joabzicg/Caiman/README.md

# Caiman

## Electronics

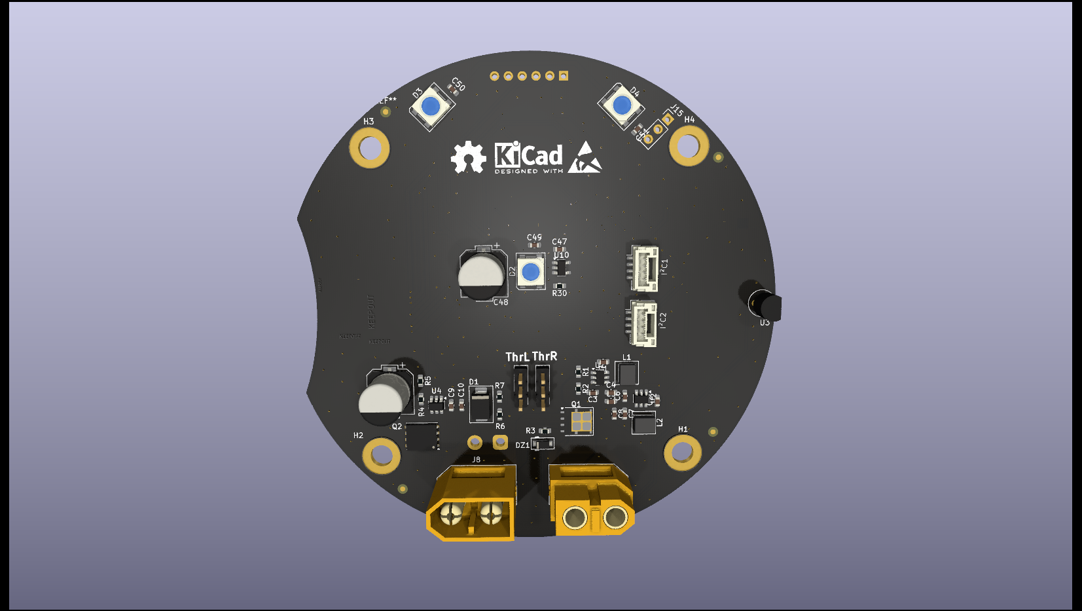
[picture p1: docs/caiman_pcb_front.png]
PCB Front view

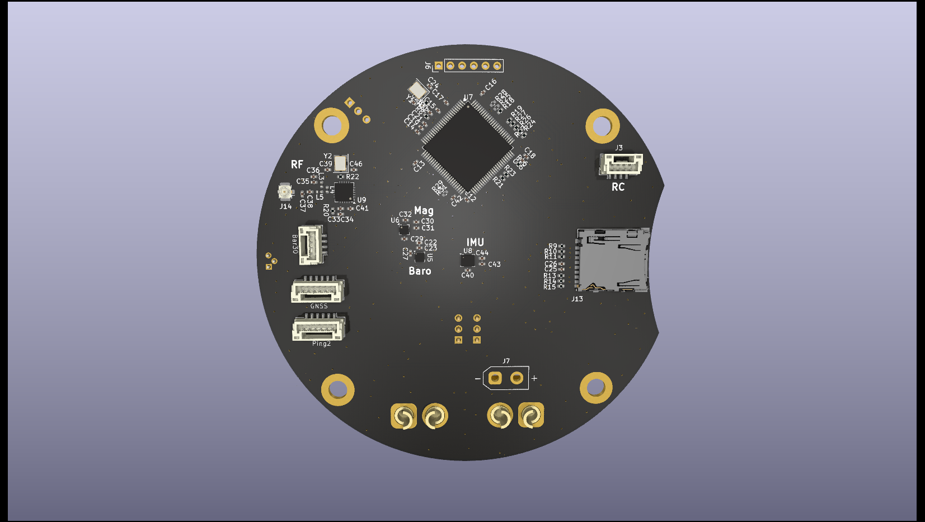
[picture p2: docs/caiman_pcb_rear.png]
PCB Rear view
