joabzicg/Caiman/electronics/production/bom_clean.csv

Designator | Footprint | Quantity | Value | LCSC Part #
C1, C2 | 0603 | 2 | 100nF
C10, C9 | 0805 | 2 | 0.1uF, 50V
C11 | CP_Elec_8x10 | 1 | 47uF, 50v
C12, C13, C14, C15, C16, C17, C18, C19, C20, C23, C26, C27, C31, C32, C40, C43 | 0402 | 16 | 100nf
C21 | 0402 | 1 | 1uF
C22, C25 | 0402 | 2 | 4.7uf
C24, C28 | 0402 | 2 | 18pF
C29 | 0402 | 1 | 220nf
C3 | 0805 | 1 | 10uF, 50v
C30, C44 | 0402 | 2 | 10uf
C33 | 0402 | 1 | 10nf
C34 | 0402 | 1 | 1nf
C35 | 0402 | 1 | 2.2nF
C36 | 0402 | 1 | 4.7pF
C37 | 0402 | 1 | 1pF
C38 | 0402 | 1 | 1.5pF
C39, C46 | 0402 | 2 | 22pF
C4, C5, C7, C8 | 0603 | 4 | 22uF, 16V
C41 | 0402 | 1 | 33nf
C42, C45 | 0402 | 2 | 2.2uF
C47, C49, C50, C51 | 0603 | 4 | 0.1uF
C48 | CP_Elec_8x10 | 1 | 470uF
C6 | 0805 | 1 | 10uF, 16v
D1 | D_SMB_TVS | 1 | SMBJ33CA
D2, D3, D4 | LED_SK6812_PLCC4_5.0x5.0mm_P3.2mm | 3 | SK6812
DZ1 | D_SOD-123F_Zener | 1 | MMSZ5245
J1, J4 | PinHeader_1x03_P2.54mm_Vertical | 2 | Conn_01x03_Pin
J10, J11, J12, J3 | JST_GH_BM04B-GHS-TBT_1x04-1MP_P1.25mm_Vertical | 4 | Conn_01x04_Pin
J13 | microSD_HC_Hirose_DM3AT-SF-PEJM5 | 1 | Micro_SD_Card
J14 | U.FL_Hirose_U.FL-R-SMT-1_Vertical | 1 | 50 ohm
J2, J5 | JST_GH_BM06B-GHS-TBT_1x06-1MP_P1.25mm_Vertical | 2 | Conn_01x04_Pin
J7 | AMASS_XT30UPB-M_1x02_P5.0mm_Vertical | 1 | Conn_01x02_Pin
J8 | AMASS_XT60-M_1x02_P7.20mm_Vertical | 1 | Conn_01x02_Pin
J9 | AMASS_XT60-F_1x02_P7.20mm_Vertical | 1 | Conn_01x02_Pin
L1 | L_Wuerth_MAPI-4020 | 1 | 4.7uH
L2 | L_Wuerth_MAPI-4020 | 1 | 3.9uH
L3 | 0402 | 1 | 2.7nH
L4 | 0402 | 1 | 8.2nH
L5 | 0402 | 1 | 3.9nH
Q1 | PowerPAK_SO-8L_Single | 1 | Q_PMOS-E_Generic_SSSGD
Q2 | TDSON-8-1 | 1 | AON6262E
R1, R4, R6 | 0603 | 3 | 100k
R10, R11, R12, R14, R15, R16, R8, R9 | 0402 | 8 | 10k
R13 | 0402 | 1 | 47k
R17, R18, R19 | 0402 | 3 | 22 ohm
R2 | 0603 | 1 | 15k
R20, R22, R24, R25, R27, R28 | 0402 | 6 | 22ohm
R21 | 0402 | 1 | 22k
R23 | 0402 | 1 | 1M
R3, R7 | 0603 | 2 | 10k
R31 | 0603 | 1 | 330
R5 | 0603 | 1 | 27k
U1 | TSOT-23-6 | 1 | AP63205WU
U10 | SOT-23-5 | 1 | SN74LV1T34DBV
U2 | TSOT-23-6 | 1 | AP63203WU
U3 | TO-92 | 1 | US1881
U4 | SOT-23-6 | 1 | LM74700
U5 | ST_HLGA-10_2x2mm_P0.5mm_LayoutBorder3x2y | 1 | LPS22HBTR
U6 | LGA-12_2x2mm_P0.5mm | 1 | LIS2MDLTR
U7 | LQFP-100_14x14mm_P0.5mm | 1 | STM32F765VITx
U8 | LGA-14_3x2.5mm_P0.5mm_LayoutBorder3x4y | 1 | LSM6DSO
U9 | QFN-20-1EP_4x4mm_P0.5mm_EP2.5x2.5mm | 1 | nRF24L01P
Y1 | Crystal_SMD_3225-4Pin_3.2x2.5mm | 1 | 8MHz
Y2 | Crystal_SMD_3225-4Pin_3.2x2.5mm | 1 | 16MHz
