joabzicg/Caiman/electronics/caiman.kicad_pcb

## KiCad design electronics/caiman.kicad_pcb (2026-06-23)

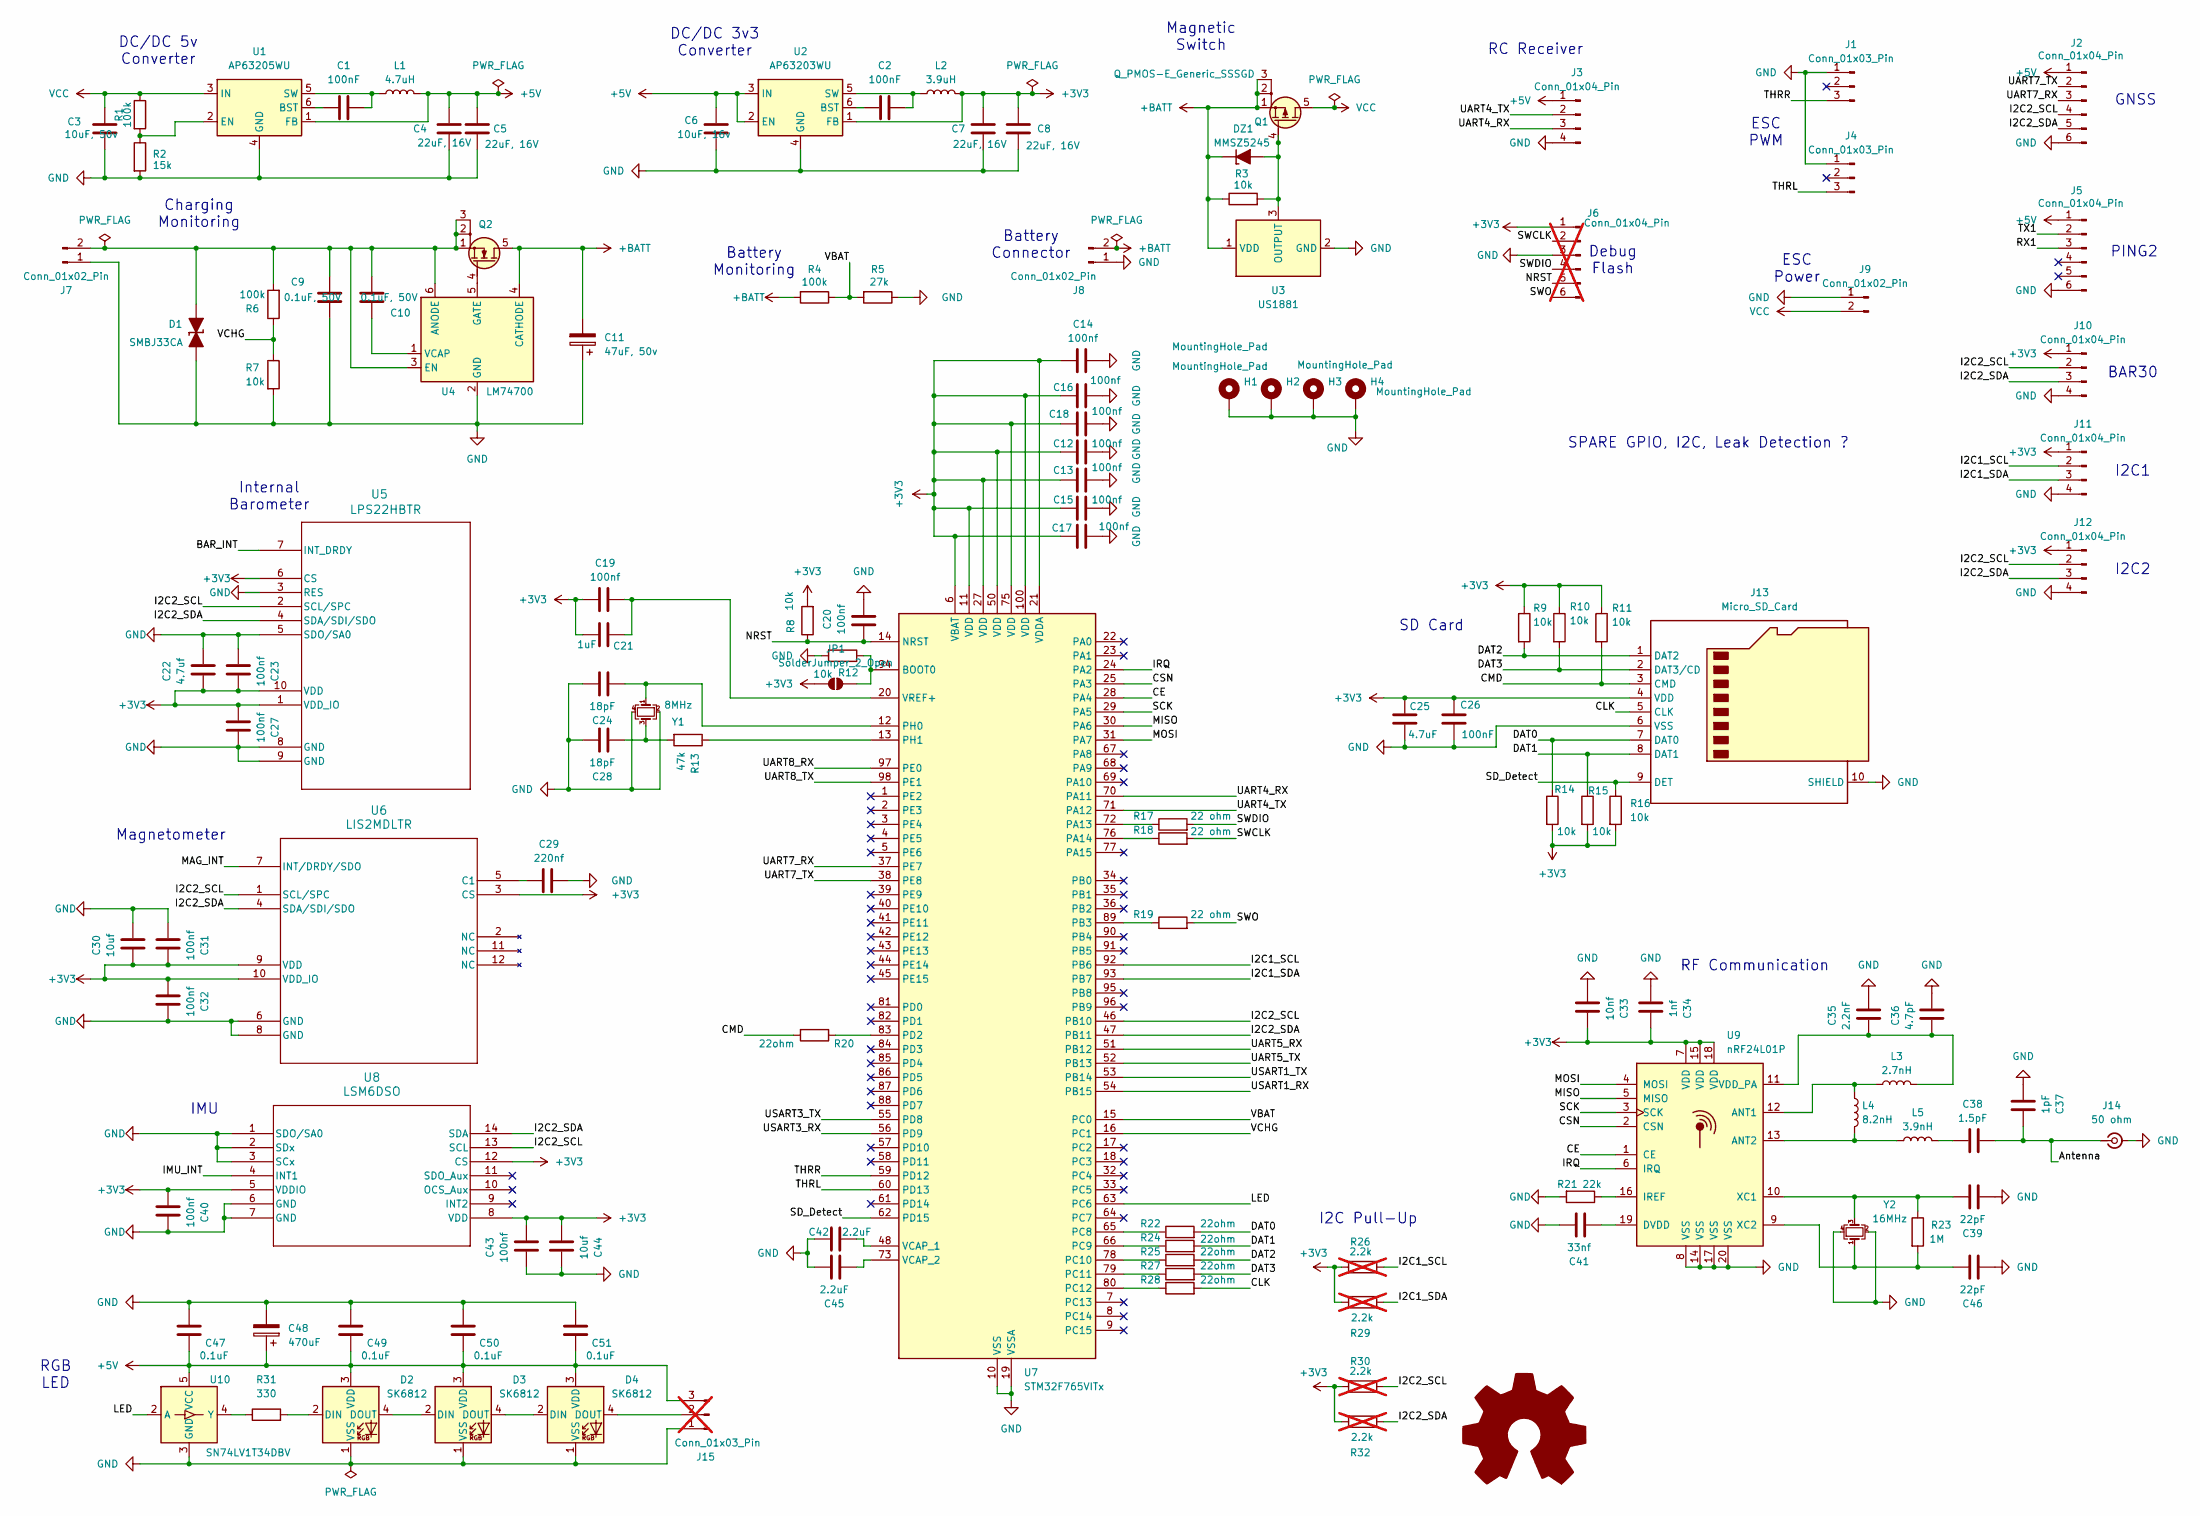
[picture p3: schematic caiman.kicad_sch]

Parts:
C1, C2: 100nF; C_0603_1608Metric
C3: 10uF, 50v; C_0805_2012Metric
C4, C5, C7, C8: 22uF, 16V; C_0603_1608Metric
C6: 10uF, 16v; C_0805_2012Metric
C9, C10: 0.1uF, 50V; C_0805_2012Metric
C11: 47uF, 50v; CP_Elec_8x10; Mouser 581-AEA0810470M063R
C12, C13, C14, C15, C16, C17, C18, C19, C20, C23, C27, C31, C32, C40, C43: 100nf; C_0402_1005Metric
C21: 1uF; C_0402_1005Metric
C22: 4.7uf; C_0402_1005Metric
C24, C28: 18pF; C_0402_1005Metric
C25: 4.7uF; C_0402_1005Metric
C26: 100nF; C_0402_1005Metric
C29: 220nf; C_0402_1005Metric
C30, C44: 10uf; C_0402_1005Metric
C33: 10nf; C_0402_1005Metric
C34: 1nf; C_0402_1005Metric
C35: 2.2nF; C_0402_1005Metric
C36: 4.7pF; C_0402_1005Metric
C37: 1pF; C_0402_1005Metric
C38: 1.5pF; C_0402_1005Metric
C39, C46: 22pF; C_0402_1005Metric
C41: 33nf; C_0402_1005Metric
C42, C45: 2.2uF; C_0402_1005Metric
C47, C49, C50, C51: 0.1uF; C_0603_1608Metric
C48: 470uF; CP_Elec_8x10; Mouser 581-AEA0810471M016R
D1: SMBJ33CA; D_SMB_TVS; Mouser 652-SMBJ33CA
D2, D3, D4: SK6812; LED_SK6812_PLCC4_5.0x5.0mm_P3.2mm; Mouser 485-4691
DZ1: MMSZ5245; D_SOD-123F_Zener
H1, H2, H3, H4: MountingHole_Pad; MountingHole_4.3mm_M4_ISO7380_Pad_TopBottom
J1, J4: Conn_01x03_Pin; PinHeader_1x03_P2.54mm_Vertical
J2, J5: Conn_01x04_Pin; JST_GH_BM06B-GHS-TBT_1x06-1MP_P1.25mm_Vertical; Mouser 306-BM06BGHSTBTLFSNN
J3, J10, J11, J12: Conn_01x04_Pin; JST_GH_BM04B-GHS-TBT_1x04-1MP_P1.25mm_Vertical; Mouser 306-BM04BGHSTBTLFSNN
J6: Conn_01x04_Pin; PinHeader_1x06_P2.54mm_Vertical; not fitted
J7: Conn_01x02_Pin; AMASS_XT30UPB-M_1x02_P5.0mm_Vertical; Mouser 426-FIT0587
J8: Conn_01x02_Pin; AMASS_XT60-M_1x02_P7.20mm_Vertical; Mouser 426-FIT0587
J9: Conn_01x02_Pin; AMASS_XT60-F_1x02_P7.20mm_Vertical; Mouser 426-FIT0587
J13: Micro_SD_Card; microSD_HC_Hirose_DM3AT-SF-PEJM5; Mouser 798-DM3ATSFPEJM511
J14: 50 ohm; U.FL_Hirose_U.FL-R-SMT-1_Vertical
J15: Conn_01x03_Pin; PinHeader_1x03_P2.54mm_Vertical; not fitted
JP1: SolderJumper_2_Open; SolderJumper-2_P1.3mm_Open_TrianglePad1.0x1.5mm
L1: 4.7uH; L_Wuerth_MAPI-4020; Mouser 652-SRP4020FA-3R3M
L2: 3.9uH; L_Wuerth_MAPI-4020; Mouser 652-SRP4020FA-2R2M
L3: 2.7nH; L_0402_1005Metric
L4: 8.2nH; L_0402_1005Metric
L5: 3.9nH; L_0402_1005Metric
Q1: Q_PMOS-E_Generic_SSSGD; PowerPAK_SO-8L_Single; Mouser 78-SQJ457EP-T1_GE3
Q2: AON6262E; TDSON-8-1; Digikey 800-3747-2-ND
R1, R4, R6: 100k; R_0603_1608Metric
R2: 15k; R_0603_1608Metric
R3, R7: 10k; R_0603_1608Metric
R5: 27k; R_0603_1608Metric
R8, R9, R10, R11, R12, R14, R15, R16: 10k; R_0402_1005Metric
R13: 47k; R_0402_1005Metric
R17, R18, R19: 22 ohm; R_0402_1005Metric
R20, R22, R24, R25, R27, R28: 22ohm; R_0402_1005Metric
R21: 22k; R_0402_1005Metric
R23: 1M; R_0402_1005Metric
R26, R29, R30, R32: 2.2k; R_0402_1005Metric; not fitted
R31: 330; R_0603_1608Metric
U1: AP63205WU; TSOT-23-6; Mouser 621-AP63205WU-7
U2: AP63203WU; TSOT-23-6; Mouser 621-AP63203WU-7
U3: US1881; TO-92; Mouser 482-1881LUAAAA000BU
U4: LM74700; SOT-23-6; Mouser 595-LM74700QDBVRQ1
U5: LPS22HBTR; ST_HLGA-10_2x2mm_P0.5mm_LayoutBorder3x2y
U6: LIS2MDLTR; LGA-12_2x2mm_P0.5mm
U7: STM32F765VITx; LQFP-100_14x14mm_P0.5mm
U8: LSM6DSO; LGA-14_3x2.5mm_P0.5mm_LayoutBorder3x4y
U9: nRF24L01P; QFN-20-1EP_4x4mm_P0.5mm_EP2.5x2.5mm
U10: SN74LV1T34DBV; SOT-23-5; Mouser 595-SN74LV1T34DBVRG4
Y1: 8MHz; Crystal_SMD_3225-4Pin_3.2x2.5mm
Y2: 16MHz; Crystal_SMD_3225-4Pin_3.2x2.5mm

Connections:
+3V3: C7.2, C8.2, C12.2, C13.2, C14.2, C15.2, C16.2, C17.2, C18.2, C19.2, C21.2, C22.1, C23.1, C25.1, C26.1, C27.2, C30.1, C31.1, C32.2, C33.1, C34.1, C40.2, C43.2, C44.2, J6.1, J10.1, J11.1, J12.1, J13.4 (VDD), JP1.1 (A), L2.2, R8.2, R9.1, R10.1, R11.1, R14.2, R15.2, R16.2, R26.1, R29.1, R30.1, R32.1, U2.1 (FB), U5.1 (VDD_IO), U5.6 (CS), U5.10 (VDD), U6.3 (CS), U6.9 (VDD), U6.10 (VDD_IO), U7.6 (VBAT), U7.11 (VDD), U7.21 (VDDA), U7.27 (VDD), U7.50 (VDD), U7.75 (VDD), U7.100 (VDD), U8.5 (VDDIO), U8.8 (VDD), U8.12 (CS), U9.7 (VDD), U9.15 (VDD), U9.18 (VDD)
+5V: C4.2, C5.2, C6.2, C47.2, C48.1, C49.2, C50.2, C51.2, D2.3 (VDD), D3.3 (VDD), D4.3 (VDD), J2.1, J3.1, J5.1, J15.3, L1.2, U1.1 (FB), U2.2 (EN), U2.3 (IN), U10.5 (VCC)
+BATT: C11.2, DZ1.1 (K), J8.2, Q1.1 (S), Q1.2 (S), Q1.3 (S), Q2.5 (D), R3.1, R4.2, U3.1 (VDD), U4.4 (CATHODE)
/Antenna: C37.2, C38.2, J14.1 (In)
/BAR_INT: U5.7 (INT_DRDY)
/CE: U7.28 (PA4), U9.1 (CE)
/CLK: J13.5 (CLK), R28.2
/CMD: J13.3 (CMD), R11.2, R20.2
/CSN: U7.25 (PA3), U9.2 (CSN)
/DAT0: J13.7 (DAT0), R14.1, R22.2
/DAT1: J13.8 (DAT1), R15.1, R24.2
/DAT2: J13.1 (DAT2), R9.2, R25.2
/DAT3: J13.2 (DAT3/CD), R10.2, R27.2
/I2C1_SCL: J11.2, R26.2, U7.92 (PB6)
/I2C1_SDA: J11.3, R29.2, U7.93 (PB7)
/I2C2_SCL: J2.4, J10.2, J12.2, R30.2, U5.2 (SCL/SPC), U6.1 (SCL/SPC), U7.46 (PB10), U8.13 (SCL)
/I2C2_SDA: J2.5, J10.3, J12.3, R32.2, U5.4 (SDA/SDI/SDO), U6.4 (SDA/SDI/SDO), U7.47 (PB11), U8.14 (SDA)
/IMU_INT: U8.4 (INT1)
/IRQ: U7.24 (PA2), U9.6 (IRQ)
/LED: U7.63 (PC6), U10.2 (A)
/MAG_INT: U6.7 (INT/DRDY/SDO)
/MISO: U7.30 (PA6), U9.5 (MISO)
/MOSI: U7.31 (PA7), U9.4 (MOSI)
/NRST: C20.2, J6.5, R8.1, U7.14 (NRST)
/RX1: J5.3
/SCK: U7.29 (PA5), U9.3 (SCK)
/SD_Detect: J13.9 (DET), R16.1, U7.62 (PD15)
/SWCLK: J6.2, R18.2
/SWDIO: J6.4, R17.2
/SWO: J6.6, R19.2
/THRL: J4.3, U7.60 (PD13)
/THRR: J1.3, U7.59 (PD12)
/TX1: J5.2
/UART4_RX: J3.3, U7.70 (PA11)
/UART4_TX: J3.2, U7.71 (PA12)
/UART5_RX: U7.51 (PB12)
/UART5_TX: U7.52 (PB13)
/UART7_RX: J2.3, U7.37 (PE7)
/UART7_TX: J2.2, U7.38 (PE8)
/UART8_RX: U7.97 (PE0)
/UART8_TX: U7.98 (PE1)
/USART1_RX: U7.54 (PB15)
/USART1_TX: U7.53 (PB14)
/USART3_RX: U7.56 (PD9)
/USART3_TX: U7.55 (PD8)
/VBAT: R4.1, R5.2, U7.15 (PC0)
/VCHG: R6.1, R7.1, U7.16 (PC1)
GND: C3.1, C4.1, C5.1, C6.1, C7.1, C8.1, C9.2, C11.1, C12.1, C13.1, C14.1, C15.1, C16.1, C17.1, C18.1, C20.1, C22.2, C23.2, C24.1, C25.2, C26.2, C27.1, C28.1, C29.1, C30.2, C31.2, C32.1, C33.2, C34.2, C35.2, C36.2, C37.1, C39.2, C40.1, C41.1, C42.2, C43.1, C44.1, C45.1, C46.2, C47.1, C48.2, C49.1, C50.1, C51.1, D1.1 (K), D2.1 (VSS), D3.1 (VSS), D4.1 (VSS), H1.1 (1_1), H2.1 (1_1), H3.1 (1_1), H4.1 (1_1), J1.1, J2.6, J3.4, J4.1, J5.6, J6.3, J7.1, J8.1, J9.1, J10.4, J11.4, J12.4, J13.6 (VSS), J13.10 (SHIELD), J14.2 (Ext), J15.1, R2.2, R5.1, R7.2, R12.2, R21.2, U1.4 (GND), U2.4 (GND), U3.2 (GND), U4.2 (GND), U5.3 (RES), U5.5 (SDO/SA0), U5.8 (GND), U5.9 (GND), U6.6 (GND), U6.8 (GND), U7.10 (VSS), U7.19 (VSSA), U7.26 (VSS), U7.49 (VSS), U7.74 (VSS), U7.99 (VSS), U8.1 (SDO/SA0), U8.2 (SDx), U8.3 (SCx), U8.6 (GND), U8.7 (GND), U9.8 (VSS), U9.14 (VSS), U9.17 (VSS), U9.20 (VSS), U10.3 (GND), Y1.2, Y1.4 (3), Y2.2, Y2.4 (3)
unnamed: C38.1, L5.2
unnamed: C9.1, C10.2, D1.2 (A), J7.2, Q2.1 (S), Q2.2 (S), Q2.3 (S), R6.2, U4.3 (EN), U4.6 (ANODE)
unnamed: D2.2 (DIN), R31.2
unnamed: D2.4 (DOUT), D3.2 (DIN)
unnamed: D3.4 (DOUT), D4.2 (DIN)
unnamed: D4.4 (DOUT), J15.2
unnamed: DZ1.2 (A), Q1.4 (G), R3.2, U3.3 (OUTPUT)
unnamed: JP1.2 (B), R12.1, U7.94 (BOOT0)
unnamed: Q2.4 (G), U4.5 (GATE)
unnamed: C1.2, U1.6 (BST)
unnamed: R1.2, R2.1, U1.2 (EN)
unnamed: C1.1, L1.1, U1.5 (SW)
unnamed: C2.2, U2.6 (BST)
unnamed: C2.1, L2.1, U2.5 (SW)
unnamed: C10.1, U4.1 (VCAP)
unnamed: C29.2, U6.5 (C1)
unnamed: R17.1, U7.72 (PA13)
unnamed: R18.1, U7.76 (PA14)
unnamed: R19.1, U7.89 (PB3)
unnamed: R22.1, U7.65 (PC8)
unnamed: R24.1, U7.66 (PC9)
unnamed: R25.1, U7.78 (PC10)
unnamed: R27.1, U7.79 (PC11)
unnamed: R28.1, U7.80 (PC12)
unnamed: R20.1, U7.83 (PD2)
unnamed: C24.2, U7.12 (PH0), Y1.1
unnamed: R13.1, U7.13 (PH1)
unnamed: C42.1, U7.48 (VCAP_1)
unnamed: C45.2, U7.73 (VCAP_2)
unnamed: C19.1, C21.1, U7.20 (VREF+)
unnamed: L3.1, L4.1, U9.12 (ANT1)
unnamed: L4.2, L5.1, U9.13 (ANT2)
unnamed: C41.2, U9.19 (DVDD)
unnamed: R21.1, U9.16 (IREF)
unnamed: C35.1, C36.1, L3.2, U9.11 (VDD_PA)
unnamed: C39.1, R23.1, U9.10 (XC1), Y2.3 (4)
unnamed: C46.1, R23.2, U9.9 (XC2), Y2.1
unnamed: R31.1, U10.4 (Y)
unnamed: C28.2, R13.2, Y1.3 (4)
VCC: C3.2, J9.2, Q1.5 (D), R1.1, U1.3 (IN)

Notes on the sheet:
GNSS
RGB LED
Magnetic Switch
Charging Monitoring
IMU
SD Card
SPARE GPIO, I2C, Leak Detection ?
PING2
Magnetometer
RC Receiver
BAR30
RF Communication
Internal Barometer
ESC Power
Battery Connector
I2C1
Battery Monitoring
I2C2
Debug Flash
DC/DC 5v Converter
I2C Pull-Up
ESC PWM
DC/DC 3v3 Converter

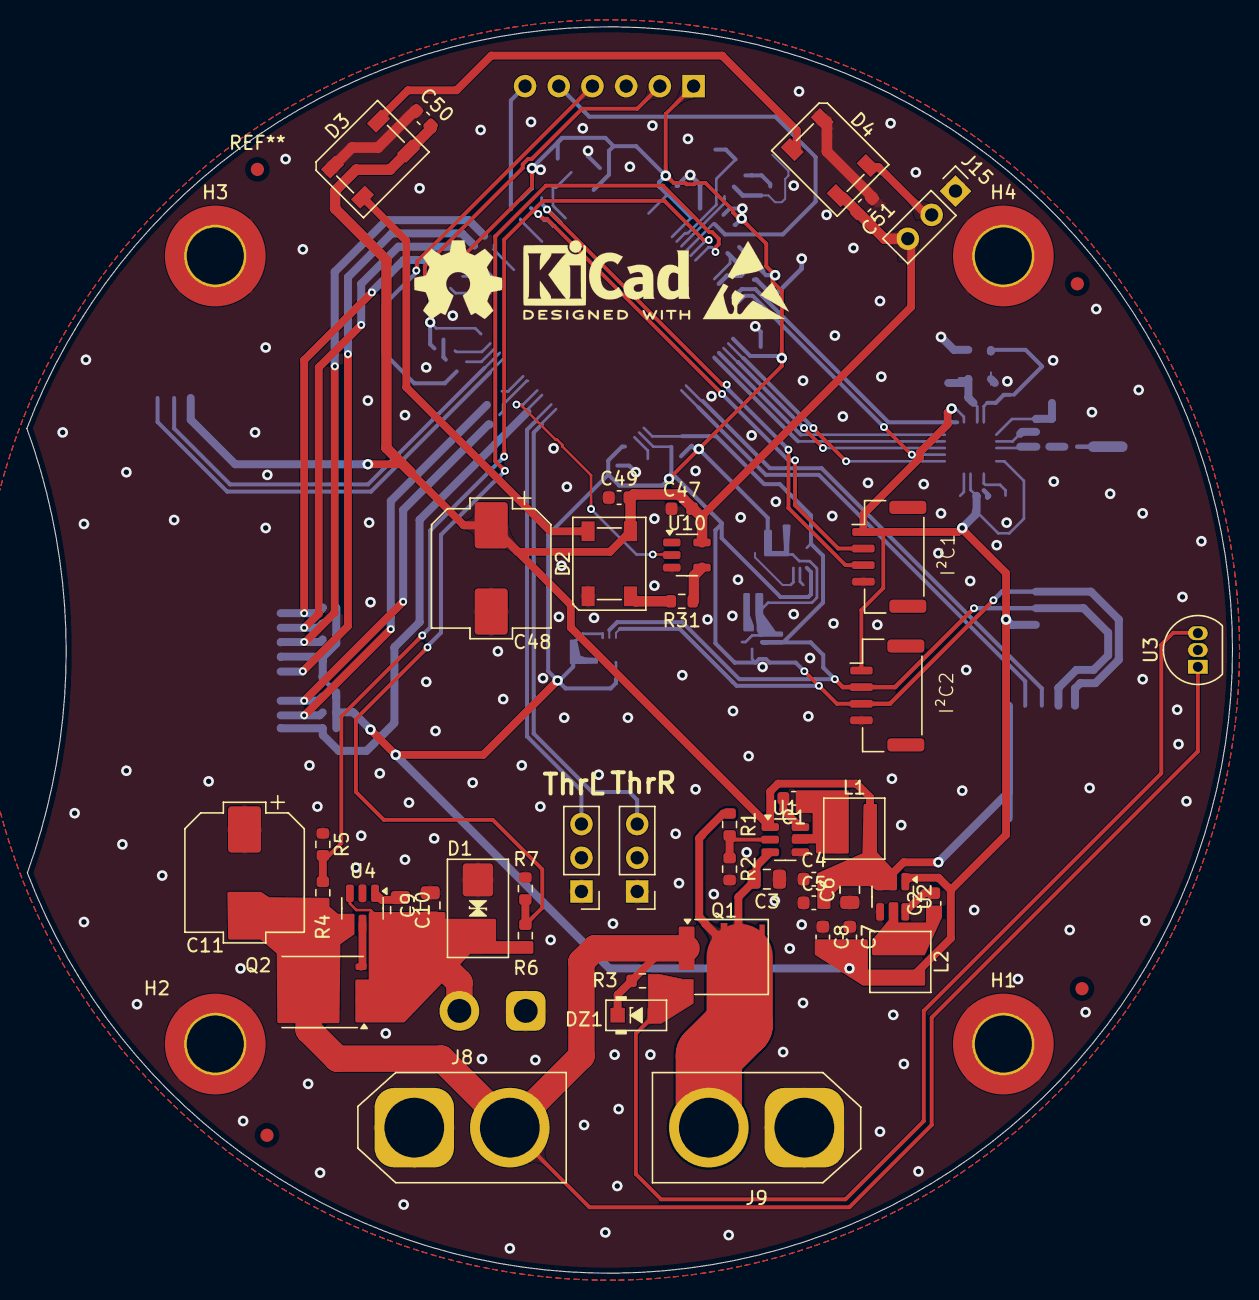
[picture p4: board caiman.kicad_pcb from above]

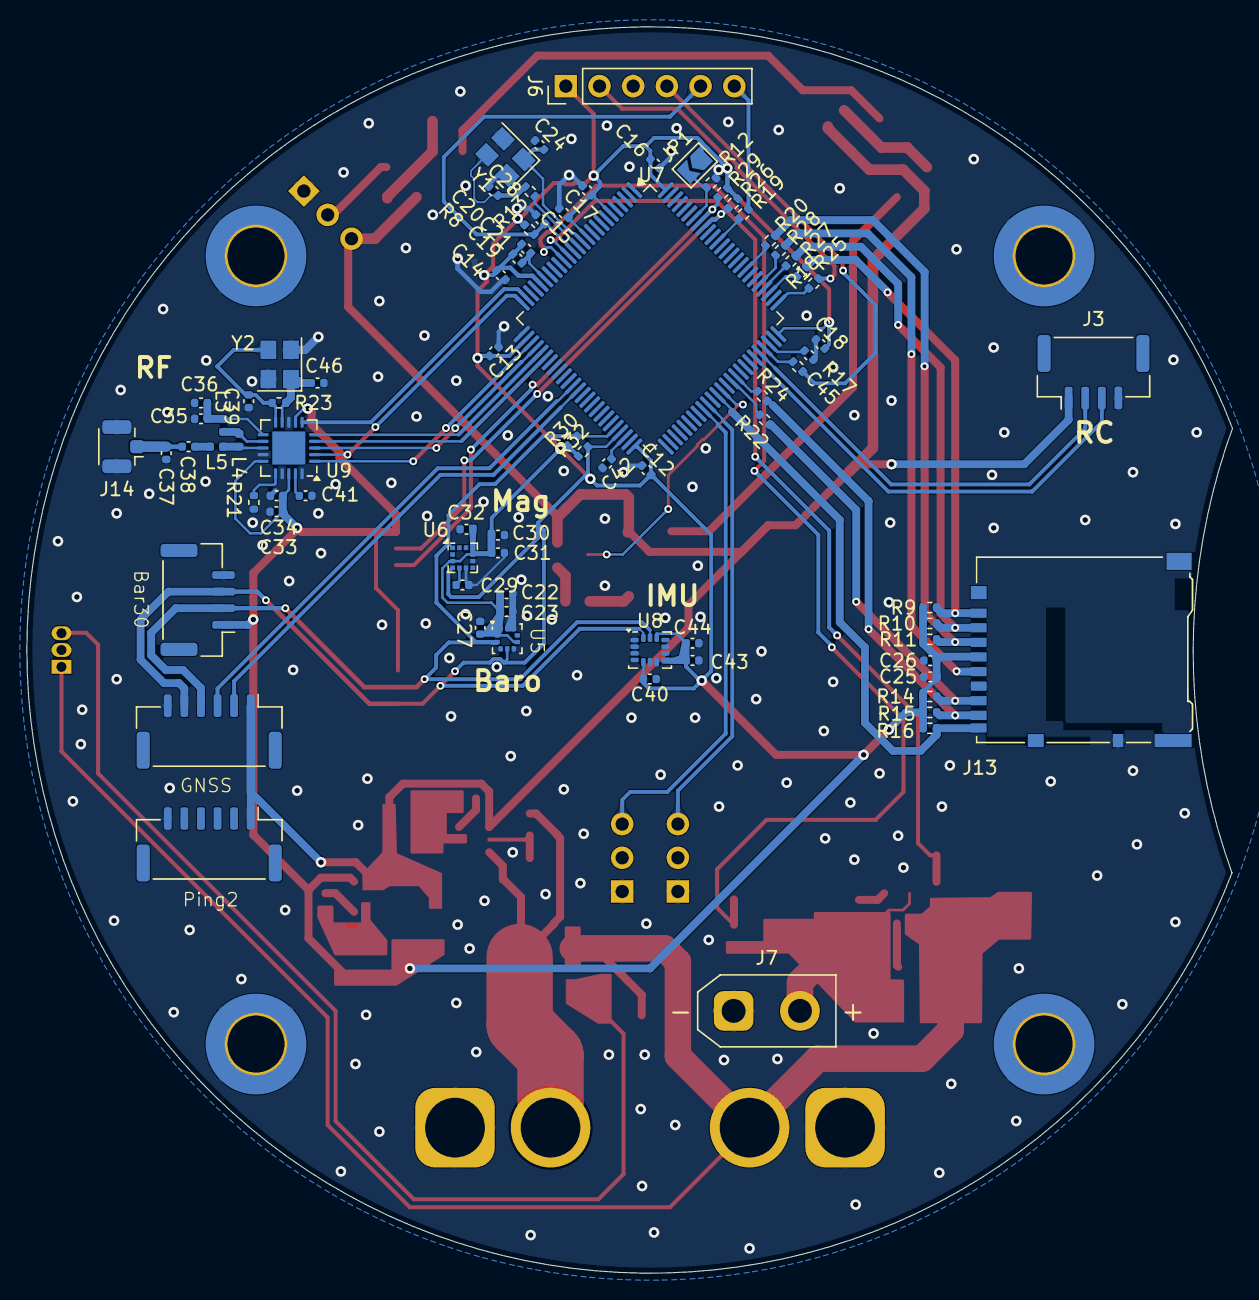
[picture p5: board caiman.kicad_pcb from below]

Board: 2 copper layers, 90.9 x 93.9 mm, 127 parts (78 on the bottom side), 75 nets.
