joabzicg/Caiman/firmware/firmware.ioc

Mcu.UserName=STM32F765VITx
PC0.Signal=ADCx_IN10
PC1.Signal=ADCx_IN11
PA11.Signal=UART4_RX
PA12.Signal=UART4_TX
PA13.Signal=SYS_JTMS-SWDIO
PA14.Signal=SYS_JTCK-SWCLK
PA5.Signal=SPI1_SCK
PA6.Signal=SPI1_MISO
PA7.Signal=SPI1_MOSI
PB10.Signal=I2C2_SCL
PB11.Signal=I2C2_SDA
PB12.Signal=UART5_RX
PB13.Signal=UART5_TX
PB14.Signal=USART1_TX
PB15.Signal=USART1_RX
PB3.Signal=SYS_JTDO-SWO
PB6.Signal=I2C1_SCL
PB7.Signal=I2C1_SDA
PC10.Signal=SDMMC1_D2
PC11.Signal=SDMMC1_D3
PC12.Signal=SDMMC1_CK
PC6.GPIO_Label=LED
PC6.Signal=S_TIM3_CH1
PC8.Signal=SDMMC1_D0
PC9.Signal=SDMMC1_D1
PD12.GPIO_Label=THRR
PD12.Signal=S_TIM4_CH1
PD13.GPIO_Label=THRL
PD13.Signal=S_TIM4_CH2
PD15.GPIO_Label=SD_Detect
PD15.Signal=GPIO_Input
PD2.Signal=SDMMC1_CMD
PD8.Signal=USART3_TX
PD9.Signal=USART3_RX
PE0.Signal=UART8_RX
PE1.Signal=UART8_TX
PE7.Signal=UART7_RX
PE8.Signal=UART7_TX
