joabzicg/Caiman/firmware/Core/Inc/main.h

#define THRR_Pin GPIO_PIN_12
#define THRR_GPIO_Port GPIOD
#define THRL_Pin GPIO_PIN_13
#define THRL_GPIO_Port GPIOD
#define SD_Detect_Pin GPIO_PIN_15
#define SD_Detect_GPIO_Port GPIOD
#define LED_Pin GPIO_PIN_6
#define LED_GPIO_Port GPIOC
