joabzicg/Caiman/(commit log)

2026-05-12 Electronic PCB
    [caiman.kicad_pcb, caiman.kicad_sch]
2026-06-01 Updating the PCB
    [caiman.kicad_pcb, caiman.kicad_sch]
2026-06-03 STM32 Power Supply correction
    Modified series capacitors to parallel capacitors in STM32
    [caiman.kicad_sch]
2026-06-03 [SYMB/MODELS] Change GND type port LSM6DSO
    Change GND port to power supply input.
    [caiman.kicad_sch]
2026-06-03 [SCHEMATICS] Duplicated Power Flags removal
    Removal of duplicated power flags symbols, and added at the VSS of RGBLED's.
    [caiman.kicad_sch]
2026-06-08 DRC Clean
    [caiman.kicad_pcb, caiman.kicad_sch]
2026-06-09 final DRC verification
    finished for fabrication
    [caiman.kicad_pcb]
2026-06-10 Drivers implementation
    Firmware implementation and simulation in wokwi.
    [bom.csv, caiman.kicad_pcb, designators.csv, positions.csv]
2026-06-19 [Schm & PCB] Footprint correction
    [bom_clean.csv, caiman.kicad_pcb, caiman.kicad_sch, positions_clean.csv]
2026-06-23 Finalization of PCB
    [caiman.kicad_pcb, positions.csv]
